IgorBanin/timelaser/images/40293604_1026385217540250_1169050661581488128_n.jpg

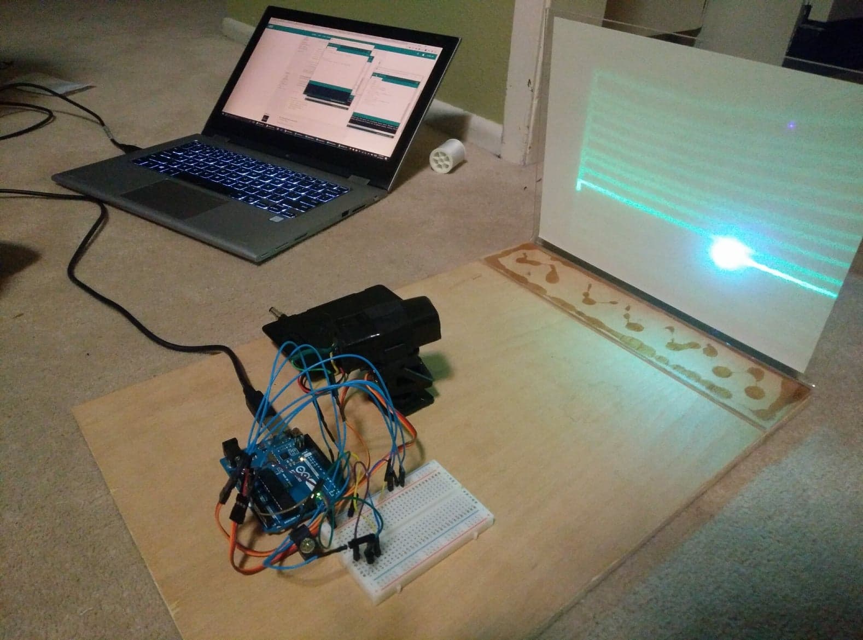
images/40293604_1026385217540250_1169050661581488128_n.jpg
